szadil763/cama-suspensa-por-impressos/stl/18_no_base_BM37_superior_x1.stl

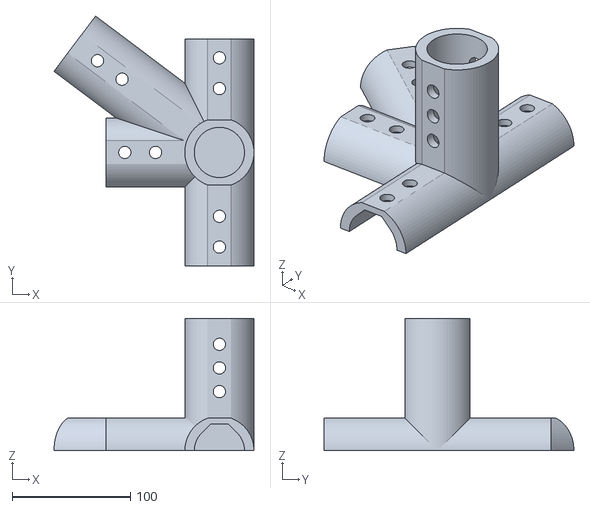
[picture p1: CAD file, 2026-10-14]
stl/18_no_base_BM37_superior_x1.stl
169.1 x 211.3 x 112.0
