szadil763/cama-suspensa-por-impressos/stl/09_colar_PC_x12.stl

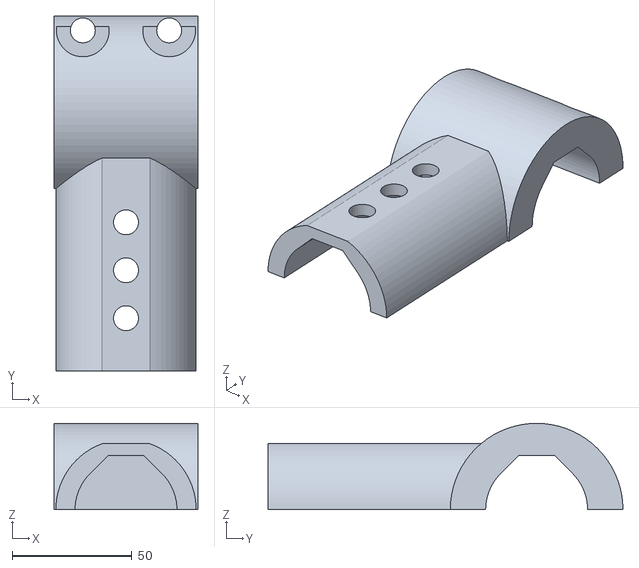
[picture p2: CAD file, 2026-10-14]
stl/09_colar_PC_x12.stl
60.0 x 148.0 x 36.0
