szadil763/cama-suspensa-por-impressos/stl/17_no_base_BM385_inferior_x1.stl

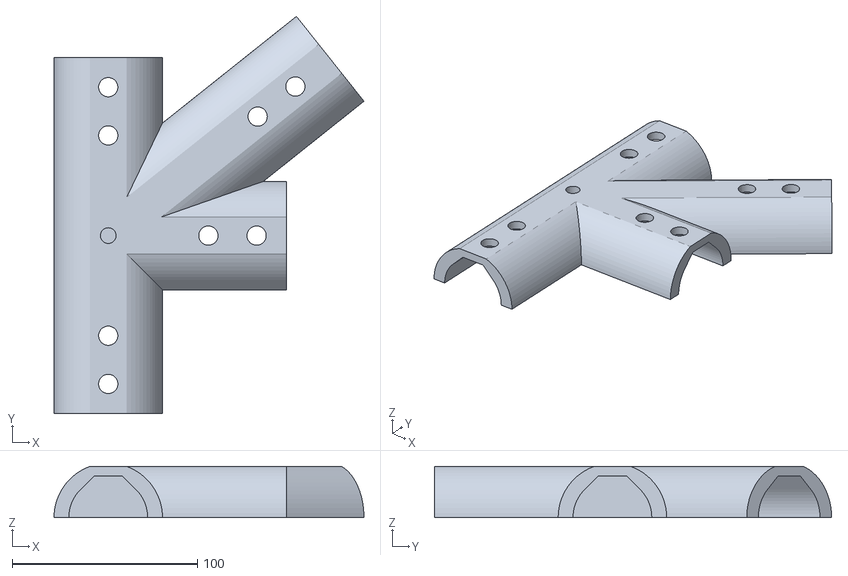
[picture p3: CAD file, 2026-10-14]
stl/17_no_base_BM385_inferior_x1.stl
167.2 x 214.2 x 27.5
