szadil763/cama-suspensa-por-impressos/stl/22_cabeceira_F_xpos_x2.stl

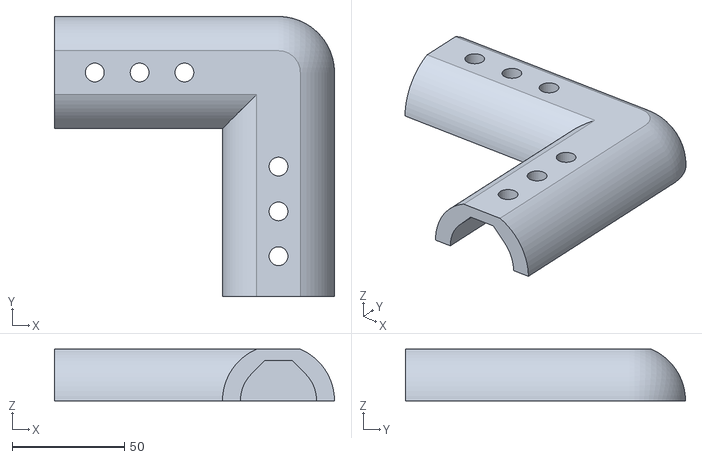
[picture p4: CAD file, 2026-10-14]
stl/22_cabeceira_F_xpos_x2.stl
125.0 x 125.0 x 23.0
