szadil763/cama-suspensa-por-impressos/stl/91_teste_soquete_1_x2.stl

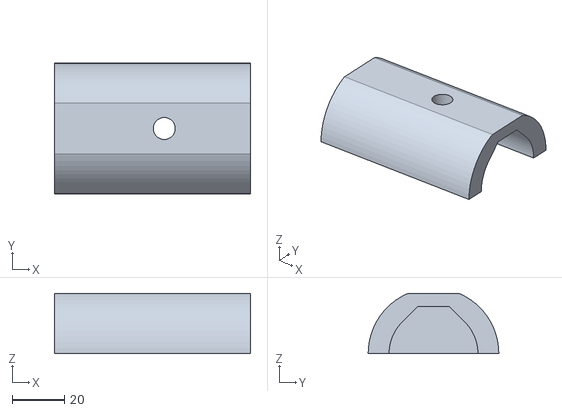
[picture p5: CAD file, 2026-10-14]
stl/91_teste_soquete_1_x2.stl
75.0 x 50.0 x 23.0
