szadil763/cama-suspensa-por-impressos/stl/23_cabeceira_G_xpos_x2.stl

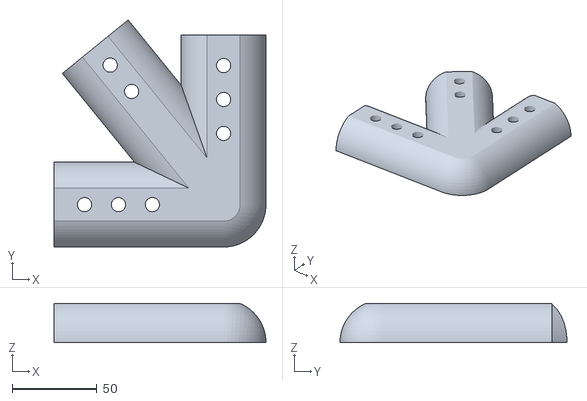
[picture p6: CAD file, 2026-10-14]
stl/23_cabeceira_G_xpos_x2.stl
125.0 x 133.9 x 23.0
