szadil763/cama-suspensa-por-impressos/stl/12_no_base_diag37_canto_superior_x1.stl

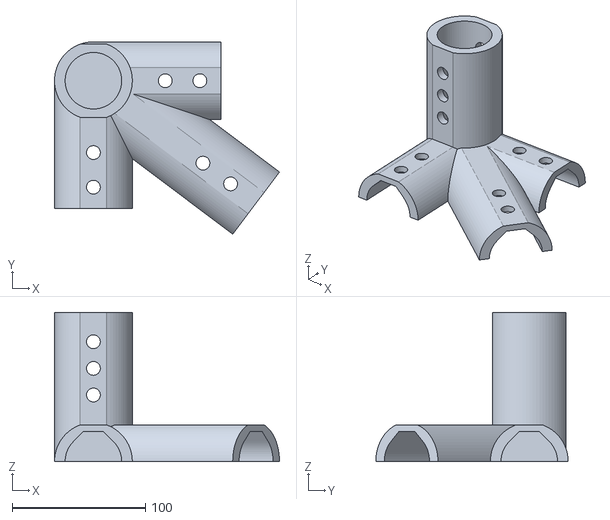
[picture p7: CAD file, 2026-10-14]
stl/12_no_base_diag37_canto_superior_x1.stl
169.1 x 144.6 x 112.0
