szadil763/cama-suspensa-por-impressos/stl/01_sela_tipo1_superior_x6.stl

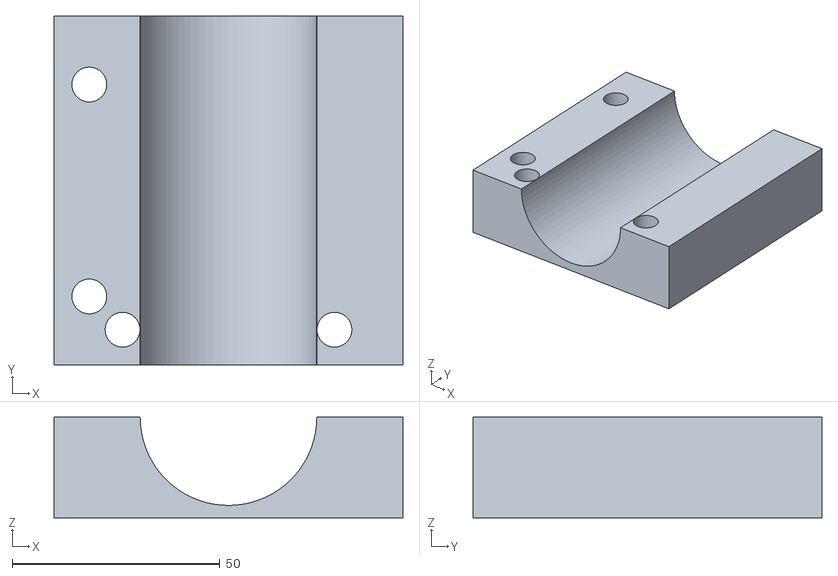
[picture p8: CAD file, 2026-10-14]
stl/01_sela_tipo1_superior_x6.stl
84.0 x 84.0 x 24.2
