szadil763/cama-suspensa-por-impressos/stl/11_no_base_liso_inferior_x2.stl

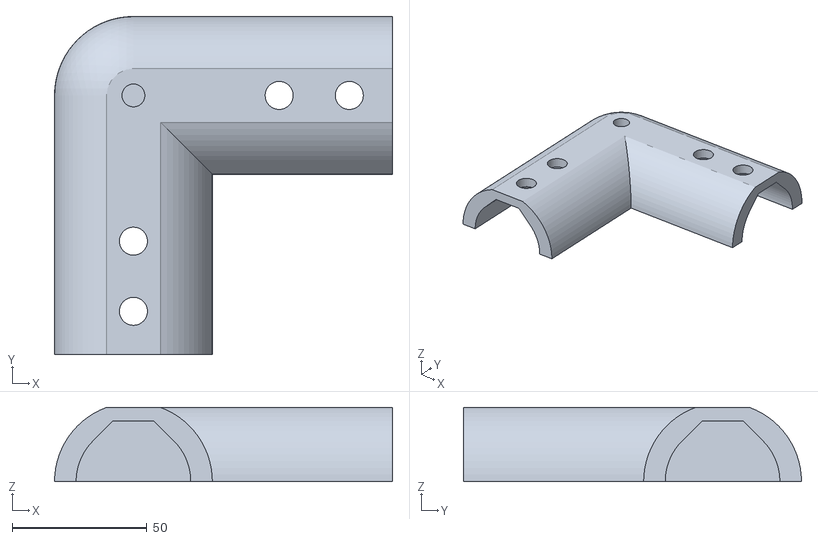
[picture p9: CAD file, 2026-10-14]
stl/11_no_base_liso_inferior_x2.stl
125.2 x 125.2 x 27.5
