szadil763/cama-suspensa-por-impressos/stl/14_no_base_diag385_canto_superior_x1.stl

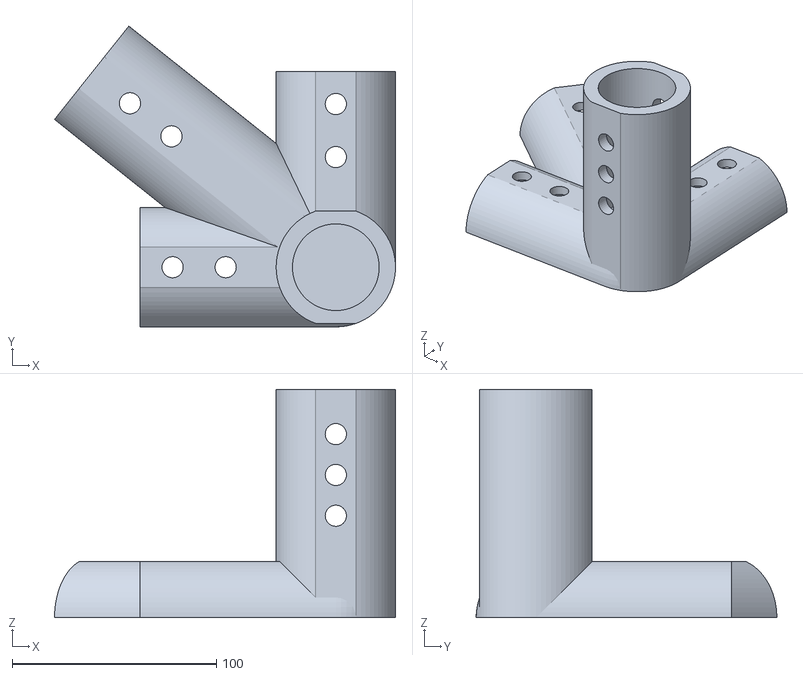
[picture p10: CAD file, 2026-10-14]
stl/14_no_base_diag385_canto_superior_x1.stl
167.2 x 147.4 x 112.0
