szadil763/cama-suspensa-por-impressos/stl/90_teste_soquete_1_1-4_x2.stl

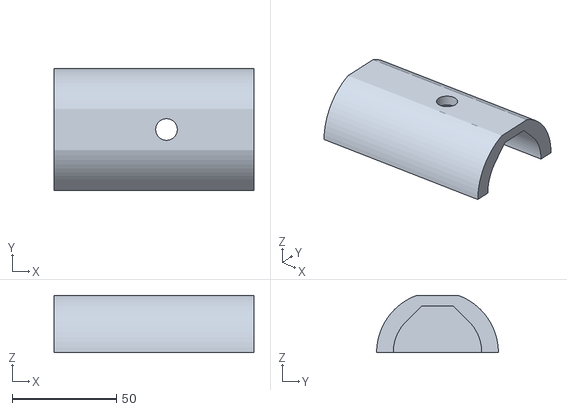
[picture p11: CAD file, 2026-10-14]
stl/90_teste_soquete_1_1-4_x2.stl
96.0 x 58.5 x 27.5
