szadil763/cama-suspensa-por-impressos/stl/24_cabeceira_H_x4.stl

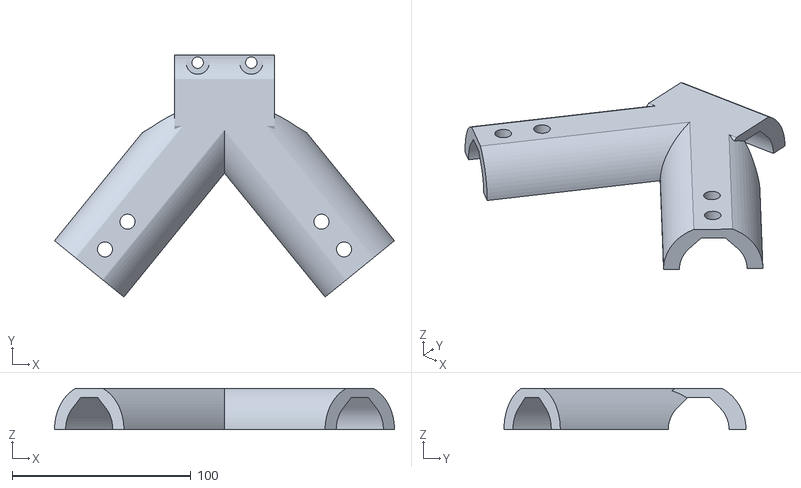
[picture p12: CAD file, 2026-10-14]
stl/24_cabeceira_H_x4.stl
190.1 x 135.4 x 23.0
