szadil763/cama-suspensa-por-impressos/stl/10_no_base_liso_superior_x2.stl

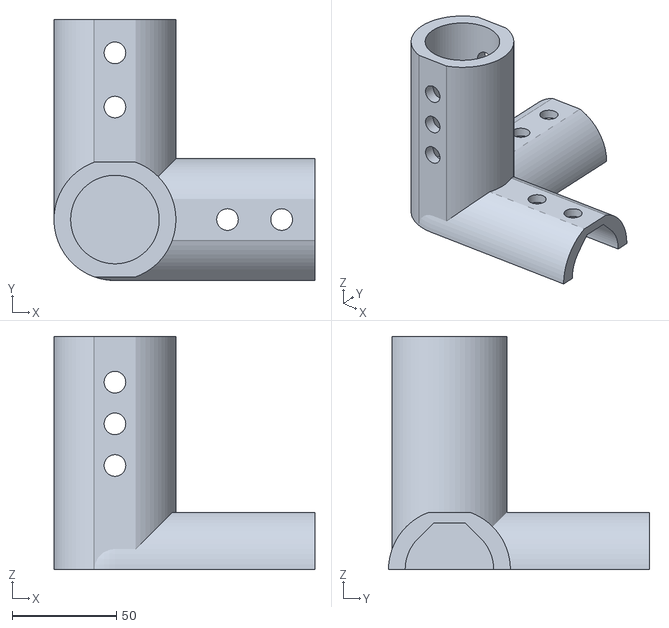
[picture p13: CAD file, 2026-10-14]
stl/10_no_base_liso_superior_x2.stl
125.2 x 125.2 x 112.0
