szadil763/cama-suspensa-por-impressos/stl/15_no_base_diag385_canto_inferior_x1.stl

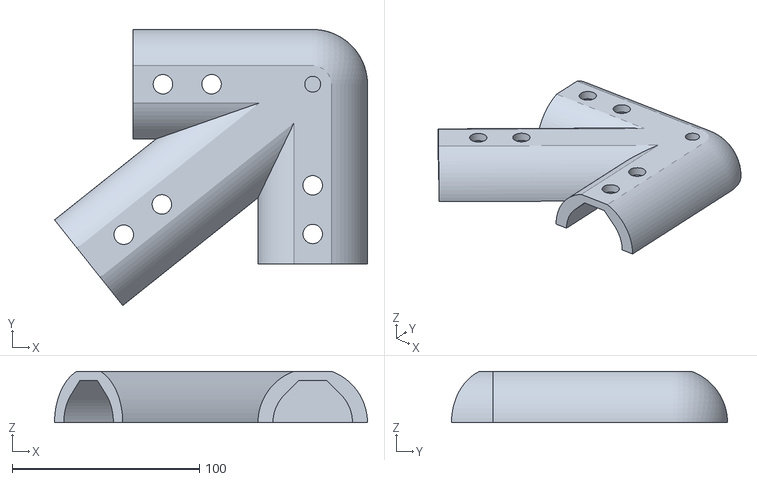
[picture p14: CAD file, 2026-10-14]
stl/15_no_base_diag385_canto_inferior_x1.stl
167.2 x 147.4 x 27.5
