szadil763/cama-suspensa-por-impressos/stl/13_no_base_diag37_canto_inferior_x1.stl

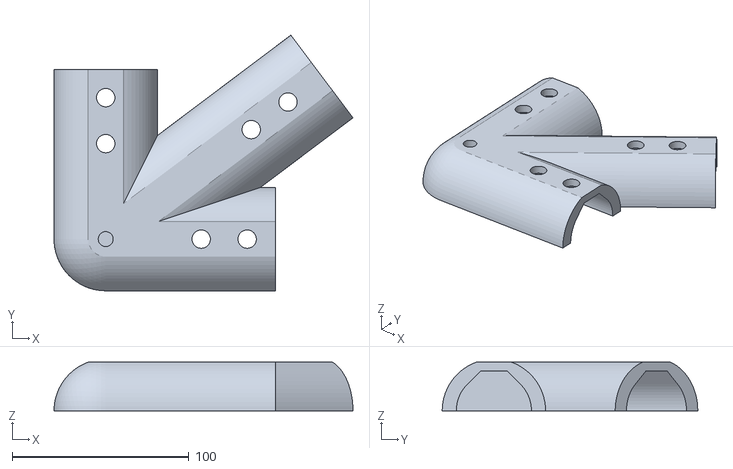
[picture p15: CAD file, 2026-10-14]
stl/13_no_base_diag37_canto_inferior_x1.stl
169.1 x 144.6 x 27.5
