szadil763/cama-suspensa-por-impressos/(list of files, cad)

Other CAD files:
stl/04_sela_tipo2_inferior_x2.stl
stl/25_cabeceira_I_x2.stl
stl/08_sela_tipo4_inferior_x1.stl
stl/20_cabeceira_F_xneg_x2.stl
stl/21_cabeceira_G_xneg_x2.stl
stl/06_sela_tipo3_inferior_x3.stl
stl/19_no_base_BM37_inferior_x1.stl
stl/03_sela_tipo2_superior_x2.stl
stl/05_sela_tipo3_superior_x3.stl
stl/16_no_base_BM385_superior_x1.stl
stl/02_sela_tipo1_inferior_x6.stl
stl/07_sela_tipo4_superior_x1.stl
