szadil763/cama-suspensa-por-impressos/docs/montagem-passo-a-passo.html

Montagem

Arraste para girar, role ou pince para aproximar

◀ Anterior ▶ Repetir etapa Próxima ▶ Tocar tudo Explodir Mostrar próximas etapas em fantasma Parede Câmera automática

Tubo galvanizado Peça impressa Aço (arruelas, grampos, suportes) Parafusos e porcas Ripas

## Simulação dos encaixes e dos parafusos

Além da animação, conferi cada encaixe do modelo: folgas entre tubo e soquete, comprimento e posição de cada parafuso, distâncias até as bordas, interferência entre os tubos e o acesso às porcas. A verificação achou 12 pontos que precisavam de correção, e todos já estão no modelo desta página.

Item | Resultado | Limite | Situação | O que mudou

A verificação é geométrica: folgas, comprimentos e colisões entre os volumes do modelo. Ela não mede a resistência do plástico nem a rigidez dos nós. Isso continua dependendo do teste do nó impresso e do teste de carga.

## Arquivos 3D para baixar

Junto desta página seguem dois arquivos GLB, com cada peça como um objeto separado e com o nome da peça:

- cama_montada.glb: a cama completa, montada.
- cama_explodida.glb: as mesmas peças afastadas na direção em que entram na montagem.

Abrem no Blender, no Visualizador 3D do Windows e em visualizadores online de glTF. Dá para esconder peças e girar para conferir cada encaixe.

As peças impressas têm arquivos STL próprios, já orientados para o fatiador, no pacote pecas_impressas_STL.zip, com o LEIA-ME que traz a lista de impressão e as ferragens.

Modelo esquemático para conferir a lógica da montagem. Medidas em centímetros, com o piso em y = 0. Usa a biblioteca three.js.
